ParticlePotato/STM32-Devkit/Pictures/PCB1.png

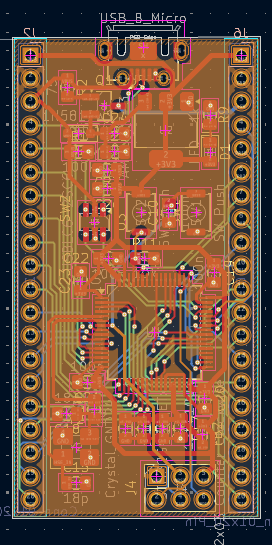
Pictures/PCB1.png
