ParticlePotato/STM32-Devkit/Pictures/PCB2.png

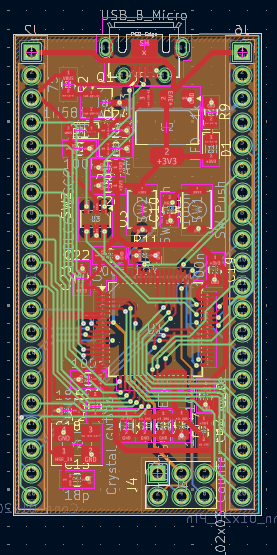
Pictures/PCB2.png
