ParticlePotato/STM32-Devkit/Pictures/PCB4.png

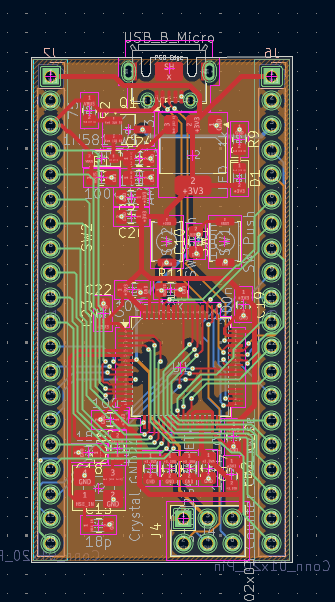
Pictures/PCB4.png
