ParticlePotato/STM32-Devkit/STM32G474/production/bom.csv

Designator | Footprint | Quantity | Value | LCSC Part #
C10, C16, C17, C19, C20, C21, C22 | 0805 | 7 | 100n | C49678
C11, C12 | 0805 | 2 | 1u | C15849
C15, C18 | 0805 | 2 | 18p | C113825
C23, C24, C25, C26, C27 | 0805 | 5 | 10u | C15850
D1 | 0805 | 1 | LED | C84260
D2 | D_SOD-323_HandSoldering | 1 | 1N5819WS | C191023
FB2 | 0805 | 1 | 120r | C15957
J2, J6 | PinHeader_1x20_P2.54mm_Vertical | 2 | Conn_01x20_Pin
J4 | PinSocket_2x03_P2.54mm_Vertical | 1 | Conn_02x03_Counter_Clockwise
J5 | USB_Micro-AB_Molex_47590-0001 | 1 | USB_B_Micro | C136001
Q1 | SOT-23_Handsoldering | 1 | AO3401A | C347476
R1 | 0805 | 1 | 100k | C149504
R10, R2 | 0805 | 2 | 75 | C2933498
R11 | 0805 | 1 | 10k | C17414
R9 | 0805 | 1 | 1k | C17513
SW1, SW2 | SW_Push_SPST_NO_Alps_SKRK | 2 | SW_Push | C262416
U1 | LQFP-64_10x10mm_P0.5mm | 1 | STM32G474RETx | C521608
U2 | SOT-223-3_TabPin2 | 1 | AMS1117-3.3 | C6186
U3 | SOT-23-6_Handsoldering | 1 | USBLC6-2SC6 | C7519
Y2 | Crystal_SMD_3225-4Pin_3.2x2.5mm_HandSoldering | 1 | Crystal_GND24 | C12668
