ParticlePotato/STM32-Devkit/STM32G474/STM32G474.kicad_pcb

## KiCad design STM32G474/STM32G474.kicad_pcb (2026-10-30)

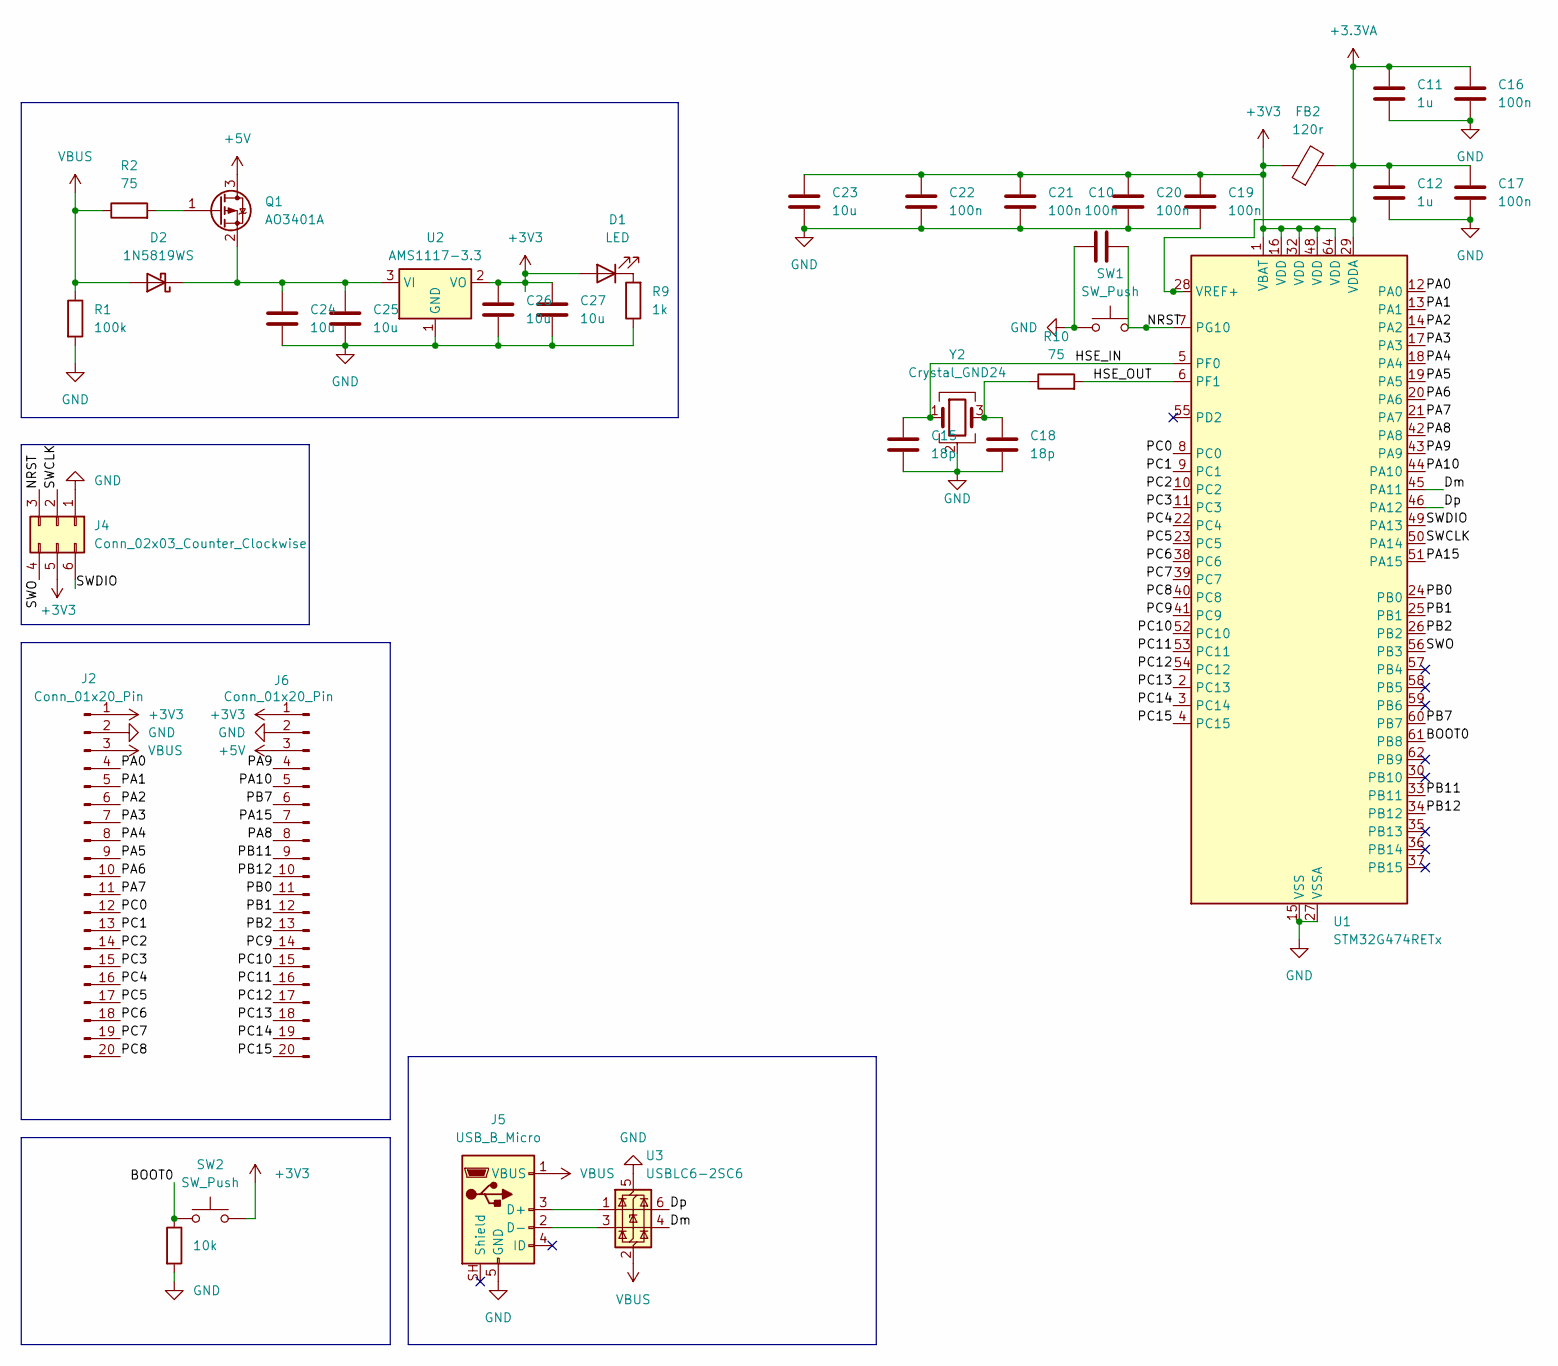
[picture p7: schematic STM32G474.kicad_sch]

Parts:
C10, C16, C17, C19, C20, C21, C22: 100n; C_0805_2012Metric_Pad1.18x1.45mm_HandSolder; LCSC C49678
C11, C12: 1u; C_0805_2012Metric_Pad1.18x1.45mm_HandSolder; LCSC C15849
C15, C18: 18p; C_0805_2012Metric_Pad1.18x1.45mm_HandSolder; LCSC C113825
C23, C24, C25, C26, C27: 10u; C_0805_2012Metric_Pad1.18x1.45mm_HandSolder; LCSC C15850
D1: LED; LED_0805_2012Metric_Pad1.15x1.40mm_HandSolder; LCSC C84260
D2: 1N5819WS; D_SOD-323_HandSoldering; LCSC C191023
FB2: 120r; L_0805_2012Metric_Pad1.05x1.20mm_HandSolder; LCSC C15957
J2, J6: Conn_01x20_Pin; PinHeader_1x20_P2.54mm_Vertical
J4: Conn_02x03_Counter_Clockwise; PinSocket_2x03_P2.54mm_Vertical
J5: USB_B_Micro; USB_Micro-AB_Molex_47590-0001; LCSC C136001
Q1: AO3401A; SOT-23_Handsoldering; LCSC C347476
R1: 100k; R_0805_2012Metric_Pad1.20x1.40mm_HandSolder; LCSC C149504
R2, R10: 75; R_0805_2012Metric_Pad1.20x1.40mm_HandSolder; LCSC C2933498
R9: 1k; R_0805_2012Metric_Pad1.20x1.40mm_HandSolder; LCSC C17513
R11: 10k; R_0805_2012Metric_Pad1.20x1.40mm_HandSolder; LCSC C17414
SW1, SW2: SW_Push; SW_Push_SPST_NO_Alps_SKRK; LCSC C262416
U1: STM32G474RETx; LQFP-64_10x10mm_P0.5mm; LCSC C521608
U2: AMS1117-3.3; SOT-223-3_TabPin2; LCSC C6186
U3: USBLC6-2SC6; SOT-23-6_Handsoldering; LCSC C7519
Y2: Crystal_GND24; Crystal_SMD_3225-4Pin_3.2x2.5mm_HandSoldering; LCSC C12668

Connections:
+3.3VA: C11.1, C12.1, C16.1, C17.1, FB2.2, U1.28 (VREF+), U1.29 (VDDA)
+3V3: C19.1, C20.1, C21.1, C22.1, C23.1, C26.1, C27.1, D1.2 (A), FB2.1, J2.1, J4.5, J6.1, SW2.2, U1.1 (VBAT), U1.16 (VDD), U1.32 (VDD), U1.48 (VDD), U1.64 (VDD), U2.2 (VO)
+5V: J6.3, Q1.3 (D)
/BOOT0: R11.1, SW2.1, U1.61 (PB8)
/Dm: U1.45 (PA11), U3.4 (I/O2)
/Dp: U1.46 (PA12), U3.6 (I/O1)
/HSE_IN: C15.1, U1.5 (PF0), Y2.1
/HSE_OUT: R10.2, U1.6 (PF1)
/NRST: C10.2, J4.3, SW1.2, U1.7 (PG10)
/PA0: J2.4, U1.12 (PA0)
/PA1: J2.5, U1.13 (PA1)
/PA2: J2.6, U1.14 (PA2)
/PA3: J2.7, U1.17 (PA3)
/PA4: J2.8, U1.18 (PA4)
/PA5: J2.9, U1.19 (PA5)
/PA6: J2.10, U1.20 (PA6)
/PA7: J2.11, U1.21 (PA7)
/PA8: J6.8, U1.42 (PA8)
/PA9: J6.4, U1.43 (PA9)
/PA10: J6.5, U1.44 (PA10)
/PA15: J6.7, U1.51 (PA15)
/PB0: J6.11, U1.24 (PB0)
/PB1: J6.12, U1.25 (PB1)
/PB2: J6.13, U1.26 (PB2)
/PB7: J6.6, U1.60 (PB7)
/PB11: J6.9, U1.33 (PB11)
/PB12: J6.10, U1.34 (PB12)
/PC0: J2.12, U1.8 (PC0)
/PC1: J2.13, U1.9 (PC1)
/PC2: J2.14, U1.10 (PC2)
/PC3: J2.15, U1.11 (PC3)
/PC4: J2.16, U1.22 (PC4)
/PC5: J2.17, U1.23 (PC5)
/PC6: J2.18, U1.38 (PC6)
/PC7: J2.19, U1.39 (PC7)
/PC8: J2.20, U1.40 (PC8)
/PC9: J6.14, U1.41 (PC9)
/PC10: J6.15, U1.52 (PC10)
/PC11: J6.16, U1.53 (PC11)
/PC12: J6.17, U1.54 (PC12)
/PC13: J6.18, U1.2 (PC13)
/PC14: J6.19, U1.3 (PC14)
/PC15: J6.20, U1.4 (PC15)
/SWCLK: J4.2, U1.50 (PA14)
/SWDIO: J4.6, U1.49 (PA13)
/SWO: J4.4, U1.56 (PB3)
GND: C10.1, C11.2, C12.2, C15.2, C16.2, C17.2, C18.2, C19.2, C20.2, C21.2, C22.2, C23.2, C24.2, C25.2, C26.2, C27.2, J2.2, J4.1, J5.5 (GND), J6.2, R1.2, R9.1, R11.2, SW1.1, U1.15 (VSS), U1.27 (VSSA), U1.31 (VSS), U1.47 (VSS), U1.63 (VSS), U2.1 (GND), U3.5 (VBUS), Y2.2 (G), Y2.4 (G)
unnamed: C18.1, R10.1, Y2.3
unnamed: D1.1 (K), R9.2
unnamed: C24.1, C25.1, D2.1 (K), Q1.2 (S), U2.3 (VI)
unnamed: J5.3 (D+), U3.1 (I/O1)
unnamed: J5.2 (D-), U3.3 (I/O2)
unnamed: Q1.1 (G), R2.2
VBUS: D2.2 (A), J2.3, J5.1 (VBUS), R1.1, R2.1, U3.2 (GND)

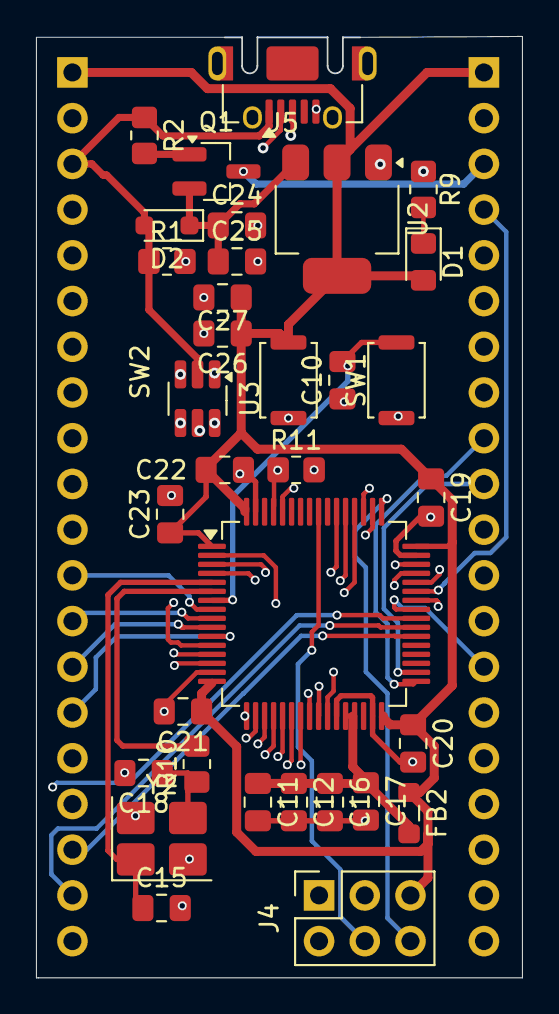
[picture p8: board STM32G474.kicad_pcb from above]

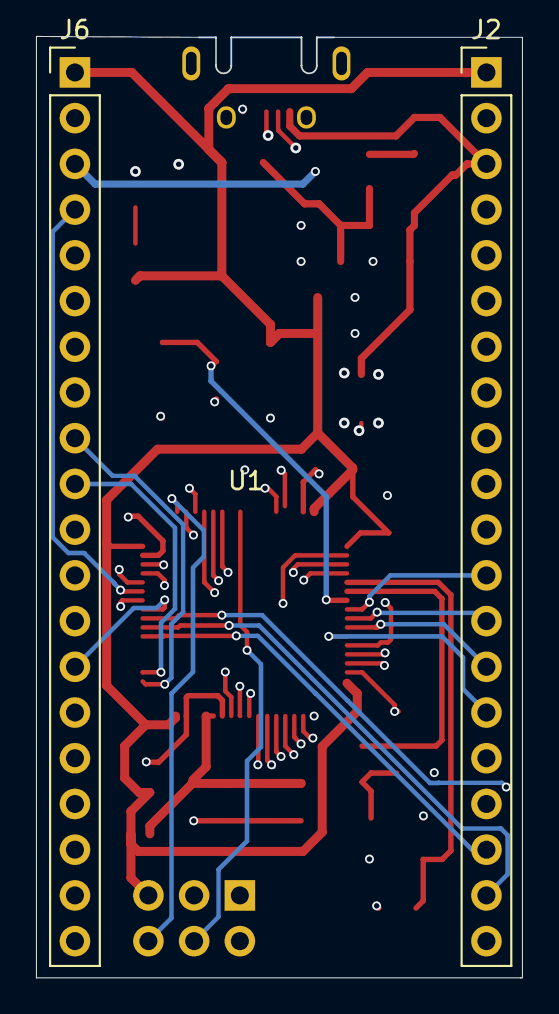
[picture p9: board STM32G474.kicad_pcb from below]

Board: 4 copper layers, 27.0 x 52.3 mm, 35 parts (2 on the bottom side), 54 nets.
