ParticlePotato/STM32-Devkit/Stm32G474_CubeMX.ioc

Mcu.UserName=STM32G474RETx
PA11.Signal=USB_DM
PA12.Signal=USB_DP
PA13.Signal=SYS_JTMS-SWDIO
PA14.Signal=SYS_JTCK-SWCLK
PB3.Signal=SYS_JTDO-SWO
PF0-OSC_IN.Signal=RCC_OSC_IN
PF1-OSC_OUT.Signal=RCC_OSC_OUT
