ParticlePotato/STM32-Devkit/(commit log)

2026-10-28 Create STM32G474
2026-10-28 Revise README for STM32G474RETx DevKit details
    Expanded the README to include detailed information about the STM32G474RETx DevKit, including key features, hardware design architecture, and header pinout layout.
2026-10-29 Correct voltage specification for Connector J6 Pin 3
    Updated the voltage specification for Pin 3 from VBUS to +5V.
2026-10-29 Fix formatting for Connector J6 pin details
2026-10-29 Enhance README with images and descriptions
    Added images for 3D view, schematic, and PCB to README.
